mrdorababu/MouseBehaviour/(list of files, drawings)

Other design files:
PCB_FILES/AnimalBehaviour.dsn
