mrdorababu/MouseBehaviour/PCB_FILES/AnimalBehaviour.kicad_pcb

## KiCad design PCB_FILES/AnimalBehaviour.kicad_pcb (2019-07-05)

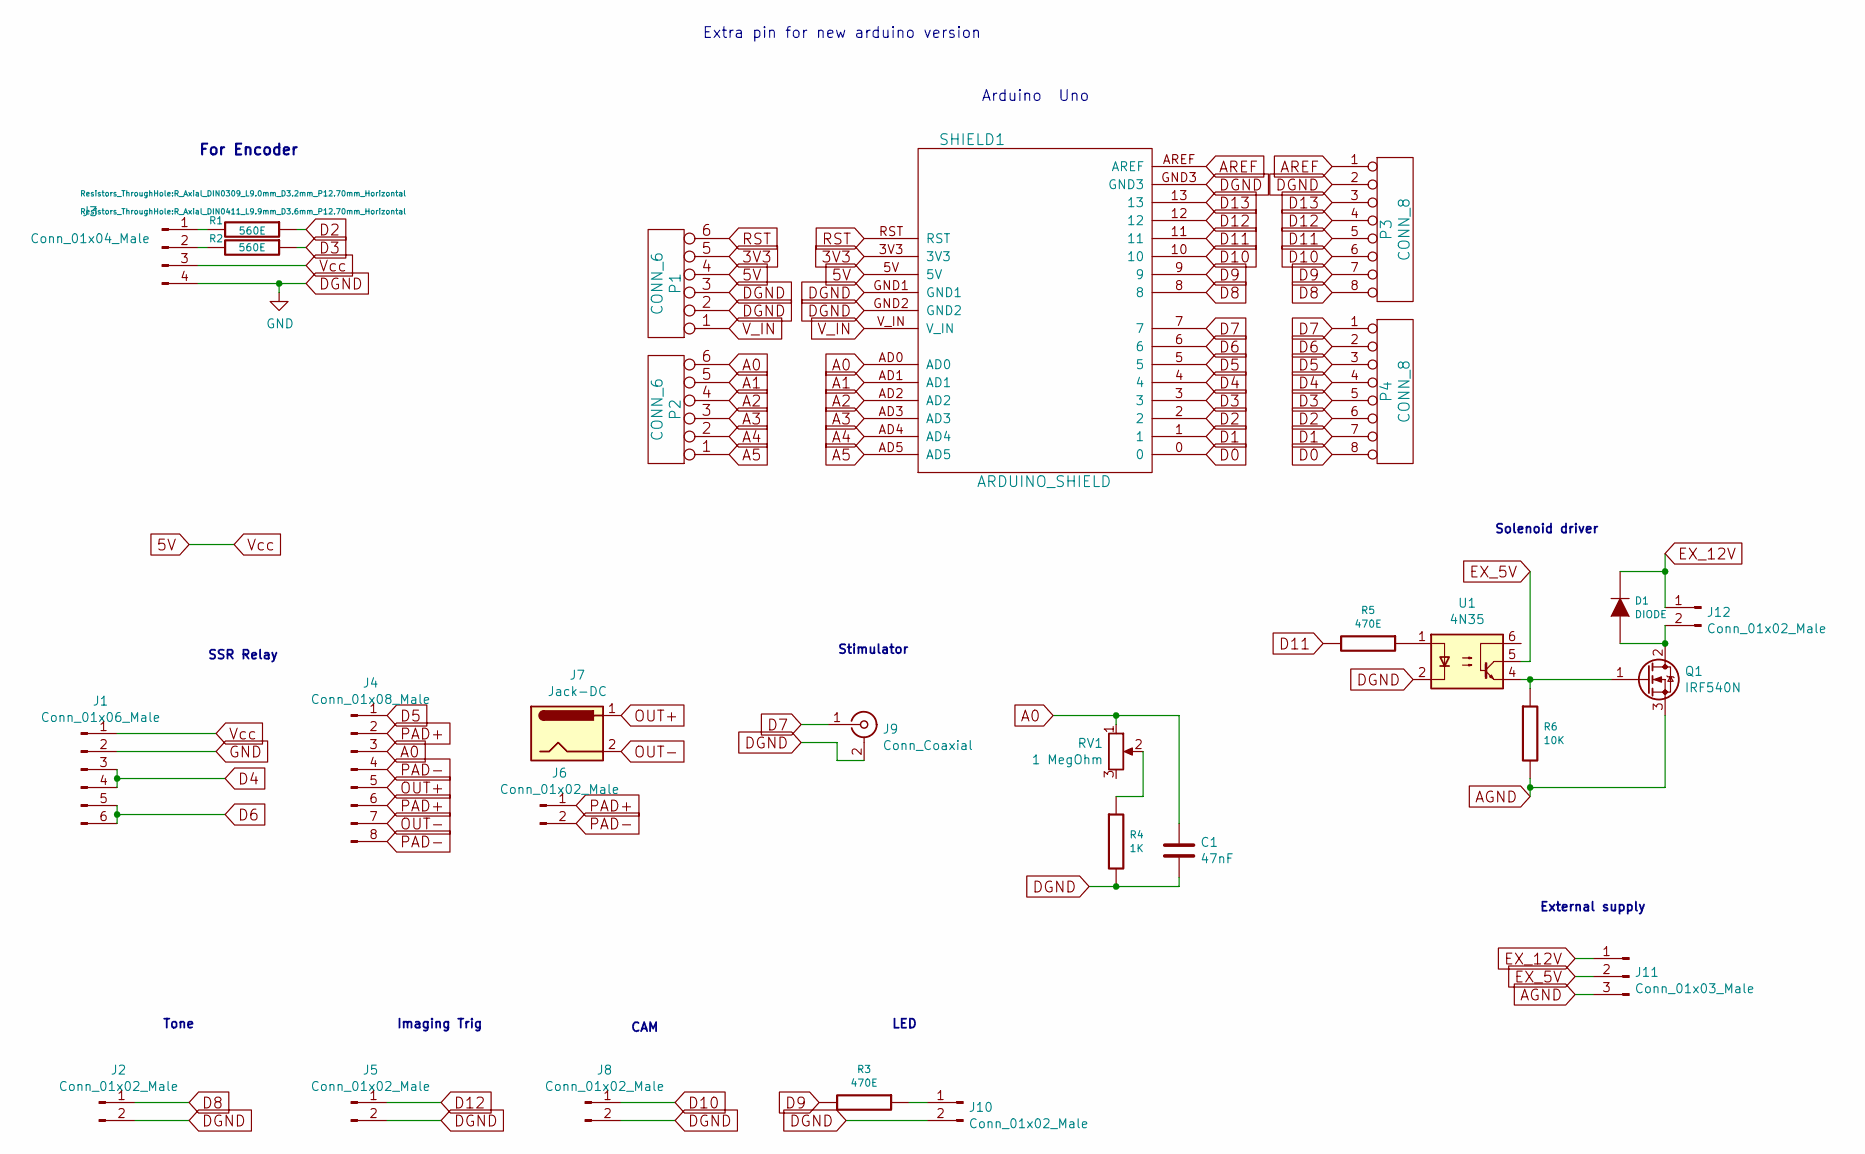
[picture p1: schematic AnimalBehaviour.sch]

Parts:
C1: 47nF; CP_Radial_D10.0mm_P5.00mm
D1: DIODE; D_5KP_P12.70mm_Horizontal
J1: Conn_01x06_Male; Molex_NanoFit_1x06x2.50mm_Straight
J2, J5, J6, J8, J10, J12: Conn_01x02_Male; Molex_NanoFit_1x02x2.50mm_Straight
J3: Conn_01x04_Male; Molex_NanoFit_1x04x2.50mm_Straight
J4: Conn_01x08_Male; Molex_NanoFit_1x08x2.50mm_Straight
J7: Jack-DC; Barrel_Jack_CUI_PJ-102AH
J9: Conn_Coaxial; bnc_90_1-1337543-0
J11: Conn_01x03_Male; Molex_NanoFit_1x03x2.50mm_Straight
P1, P2: CONN_6; Molex_NanoFit_1x06x2.50mm_Straight
P3, P4: CONN_8; Molex_NanoFit_1x08x2.50mm_Straight
Q1: IRF540N; TO-220-3_Vertical
R1: 560E; R_Axial_DIN0309_L9.0mm_D3.2mm_P12.70mm_Horizontal
R2: 560E; R_Axial_DIN0411_L9.9mm_D3.6mm_P12.70mm_Horizontal
R3, R5: 470E; R_Axial_DIN0411_L9.9mm_D3.6mm_P12.70mm_Horizontal
R4: 1K; R_Axial_DIN0411_L9.9mm_D3.6mm_P12.70mm_Horizontal
R6: 10K; R_Axial_DIN0411_L9.9mm_D3.6mm_P12.70mm_Horizontal
RV1: 1 MegOhm; PINHEAD1-3
SHIELD1: ARDUINO_SHIELD; ARDUINO_SHIELD_040pins
U1: 4N35; DIP-6_W7.62mm_Socket_LongPads

Connections:
3V3: P1.5, SHIELD1.3V3
5V: J1.1, J3.3, P1.4, SHIELD1.5V
A0: C1.1, J4.3, P2.6, RV1.1, SHIELD1.AD0
A1: P2.5, SHIELD1.AD1
A2: P2.4, SHIELD1.AD2
A3: P2.3, SHIELD1.AD3
A4: P2.2, SHIELD1.AD4
A5: P2.1, SHIELD1.AD5
AGND: J11.3, Q1.3 (S), R6.2
AREF: P3.1, SHIELD1.AREF
D0: P4.8, SHIELD1.0
D1: P4.7, SHIELD1.1
D2: P4.6, R1.1, SHIELD1.2
D3: P4.5, R2.1, SHIELD1.3
D4: J1.3, J1.4, P4.4, SHIELD1.4
D5: J4.1, P4.3, SHIELD1.5
D6: J1.5, J1.6, P4.2, SHIELD1.6
D7: J9.1 (In), P4.1, SHIELD1.7
D8: J2.1, P3.8, SHIELD1.8
D9: P3.7, R3.2, SHIELD1.9
D10: J8.1, P3.6, SHIELD1.10
D11: P3.5, R5.2, SHIELD1.11
D12: J5.1, P3.4, SHIELD1.12
D13: P3.3, SHIELD1.13
DGND: C1.2, J1.2, J2.2, J3.4, J5.2, J8.2, J9.2 (Ext), J10.2, P1.2, P1.3, P3.2, R4.2, SHIELD1.GND1, SHIELD1.GND2, SHIELD1.GND3, U1.2
EX_5V: J11.2, U1.5
EX_12V: D1.2 (K), J11.1, J12.1
unnamed: D1.1 (A), J12.2, Q1.2 (D)
unnamed: J3.1, R1.2
unnamed: J3.2, R2.2
unnamed: J10.1, R3.1
unnamed: Q1.1 (G), R6.1, U1.4
unnamed: R4.1, RV1.2
unnamed: R5.1, U1.1
OUT+: J4.5, J7.1
OUT-: J4.7, J7.2
PAD+: J4.2, J4.6, J6.1
PAD-: J4.4, J4.8, J6.2
RST: P1.6, SHIELD1.RST
V_IN: P1.1, SHIELD1.V_IN

Notes on the sheet:
Arduino Uno
For Encoder
SSR Relay
LED
Tone
Solenoid driver
Stimulator
External supply
Imaging Trig
CAM
Extra pin for new arduino version

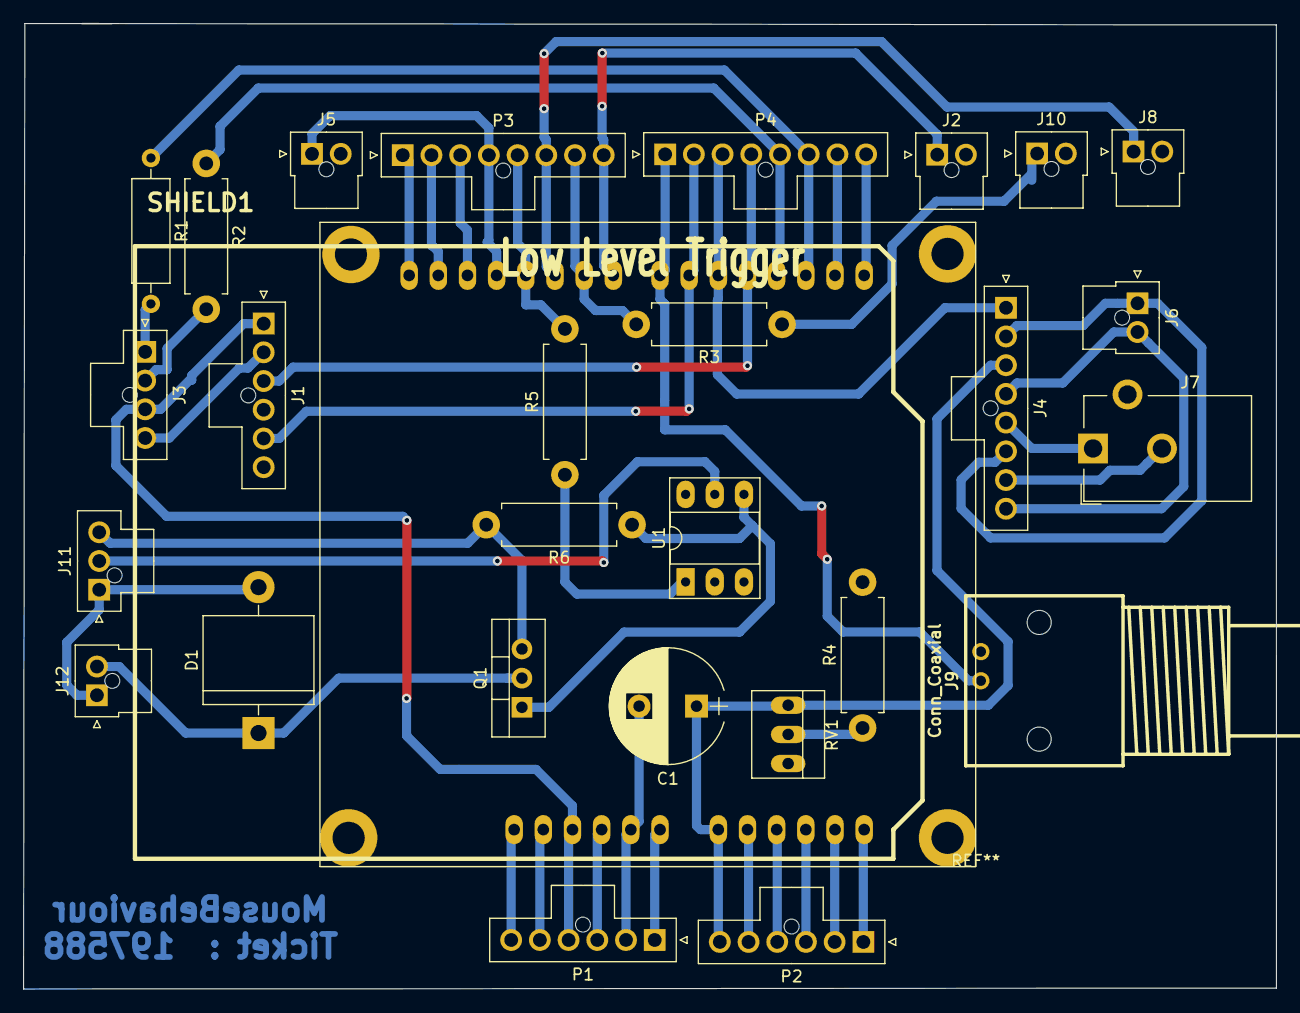
[picture p2: board AnimalBehaviour.kicad_pcb from above]

Board: 2 copper layers, 109.1 x 84.1 mm, 28 parts (0 on the bottom side), 40 nets.
