mrdorababu/MouseBehaviour/Schematic.kicad_pcb

## KiCad design Schematic.kicad_pcb (2019-07-05)

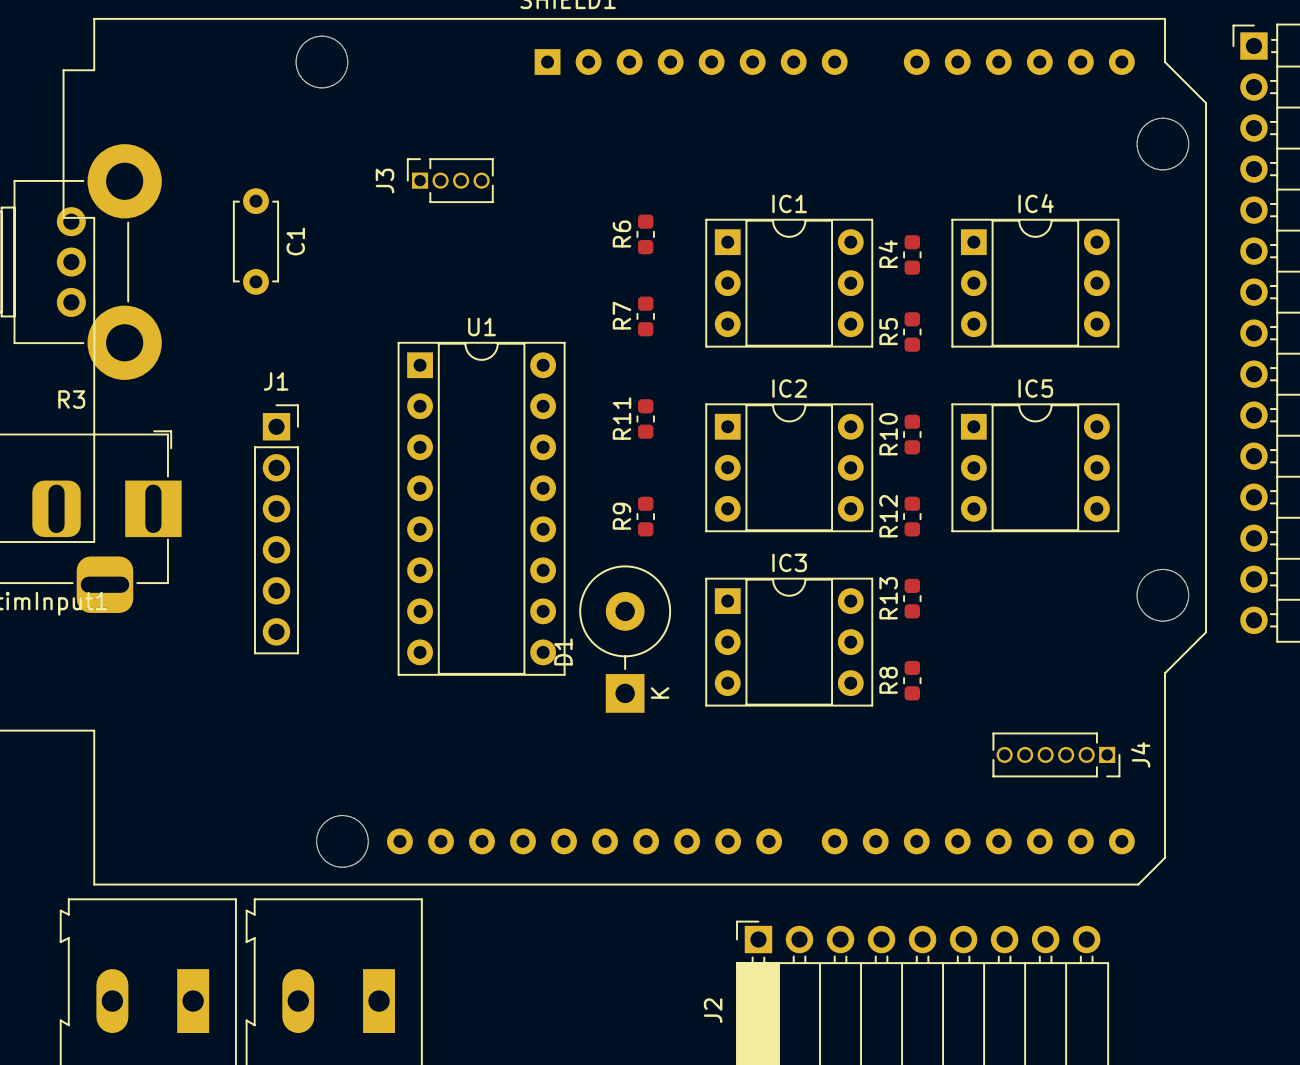
[picture p3: board Schematic.kicad_pcb from above]

Board: 2 copper layers, 28 parts (0 on the bottom side), 34 nets, no tracks yet.

Parts:
C1: 47 uF; C_Disc_D4.7mm_W2.5mm_P5.00mm
CN1: OutputPad; PinHeader_1x15_P2.54mm_Horizontal
D1: DIODE; D_DO-27_P5.08mm_Vertical_KathodeUp
IC1, IC2, IC3, IC4, IC5: 4N35; DIP-6_W7.62mm_Socket
J1: SSR-ToInput; PinSocket_1x06_P2.54mm_Vertical
J2: SSR-ToOutput; PinSocket_1x09_P2.54mm_Horizontal
J3: RotaryEncoder; PinSocket_1x04_P1.27mm_Vertical
J4: AnalogIn; PinSocket_1x06_P1.27mm_Vertical
J-InStimInput1: 90V; BarrelJack_Horizontal
JPad1: ShockPad; TerminalBlock_Altech_AK300-2_P5.00mm
JPad2: StimInput; TerminalBlock_Altech_AK300-2_P5.00mm
R3: 1M; Potentiometer_Alps_RK09K_Single_Horizontal
R4, R10, R12: 560E; R_0603_1608Metric
R5, R6: 470E; R_0603_1608Metric
R7, R8, R9, R11, R13: 15k; R_0603_1608Metric
SHIELD1: ARDUINO_SHIELD; Arduino_UNO_R3_WithMountingHoles
U1: ULN2003A; DIP-16_W7.62mm_Socket

Connections:
5V: J1.1, J3.3
12 V: CN1.11, D1.1
A0: C1.1, J2.6, J4.1, R3.1
AGND: C1.2, CN1.1, CN1.10, CN1.12, CN1.14, J3.4, R3.2, R7.1, R8.2, R9.2, R11.2, R13.2, U1.8
D2: J3.1, SHIELD1.2
D3: J3.2, SHIELD1.3
D4: J1.3, J1.4, SHIELD1.4
D5: J2.8, SHIELD1.5
D6: J1.5, J1.6, SHIELD1.6
D7: JPad2.1, SHIELD1.7
D8: R12.1, SHIELD1.8
D9: R10.1, SHIELD1.9
D11: R5.1, SHIELD1.11
D12: R6.1, SHIELD1.12
D13: R4.1, SHIELD1.13
DGND: IC1.2, IC2.2, IC3.2, IC4.2, IC5.2, J1.2, JPad2.2
EX 5 V: CN1.9, IC1.5, IC2.5, IC3.5, IC4.5, IC5.5
unnamed: IC1.1, R4.2
unnamed: IC2.1, R5.2
unnamed: IC3.1, R6.2
unnamed: IC4.1, R10.2
unnamed: IC5.1, R12.2
unnamed: J2.1, J2.5, JPad1.2
unnamed: J2.3, J2.7, JPad1.1
unnamed: J2.2, J-InStimInput1.1
unnamed: J2.4, J-InStimInput1.2
Solenoid1_1: CN1.6, CN1.8, D1.2, U1.9
Solenoid1_2: CN1.7, U1.15
Solenoid2_2: CN1.5, U1.16
Tone1: CN1.15, IC4.4, R11.1
Tone2: CN1.13, IC5.4, R13.1
Tone3: CN1.2, IC1.4, R7.2
ULN_IN1: IC2.4, R9.1, U1.1
ULN_IN2: IC3.4, R8.1, U1.2
