mrdorababu/MouseBehaviour/(commit log)

2019-04-04 Added shock pin to the arduino. #37
2019-07-05 Add files via upload
    PCB tracks updated
    [AnimalBehaviour-B_Cu.gbr, AnimalBehaviour-B_Mask.gbr, AnimalBehaviour-B_Paste.gbr, AnimalBehaviour-B_SilkS.gbr, AnimalBehaviour-Edge_Cuts.gbr, AnimalBehaviour-F_Cu.gbr, AnimalBehaviour-F_Mask.gbr, AnimalBehaviour-F_Paste.gbr]
2019-07-05 moved to a folder.
    [AnimalBehaviour-B_Cu.gbr, AnimalBehaviour-B_Mask.gbr, AnimalBehaviour-B_Paste.gbr, AnimalBehaviour-B_SilkS.gbr, AnimalBehaviour-Edge_Cuts.gbr, AnimalBehaviour-F_Cu.gbr, AnimalBehaviour-F_Mask.gbr, AnimalBehaviour-F_Paste.gbr]
